ImamJhe/Skripsi/Gambaran Alat/IMG_20220808_1250011.jpg

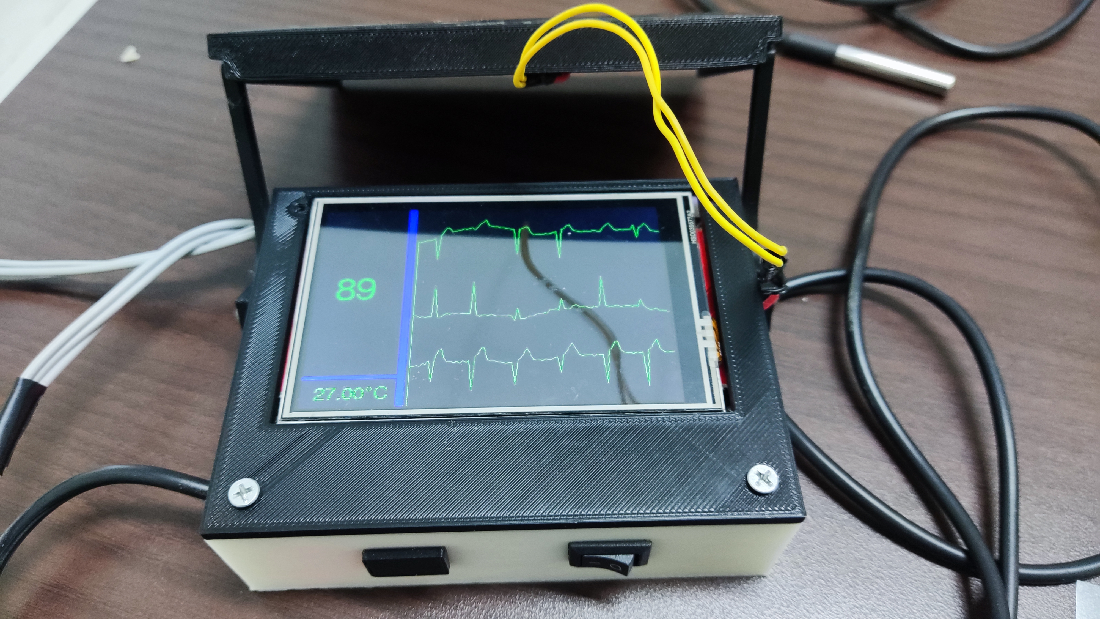
Gambaran Alat/IMG_20220808_1250011.jpg
