ImamJhe/Skripsi/Gambaran Alat/IMG_20220808_123620.jpg

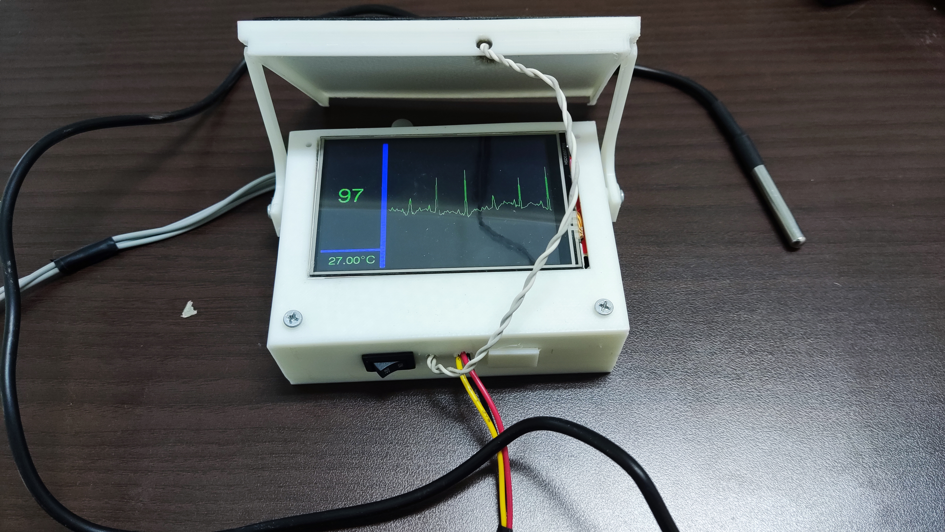
Gambaran Alat/IMG_20220808_123620.jpg
