ImamJhe/Skripsi/Readme.md

# Video Pengenalan Alat
https://github.com/ImamJhe/Skripsi/assets/95597578/f38b6d7f-bc4e-496a-82b5-ecb6b56aeb42

# Gambaran Grafik Alat pada web local
AD8232_ILI9488_1_zoom
AD8232_SH1106_zoom
ADS1293_ILI9488_1
ADS1293_ILI9488_1_zoom

# Banner Jurnal Skripsi
Banner_Jurnal
