ImamJhe/Skripsi/Gambaran Alat/bagian samping.png

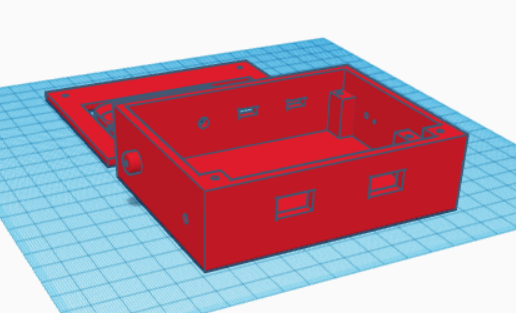
Gambaran Alat/bagian samping.png
