ImamJhe/Skripsi/Gambaran Alat/Dimensi pxl.png

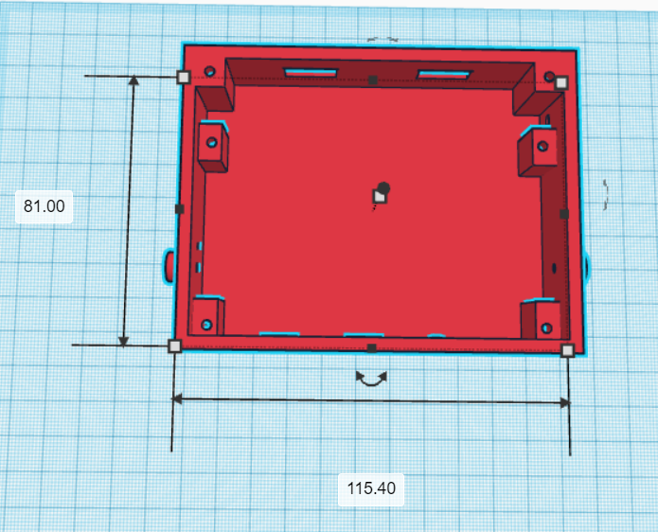
Gambaran Alat/Dimensi pxl.png
