ImamJhe/Skripsi/Gambaran Alat/dimensi tinggi.png

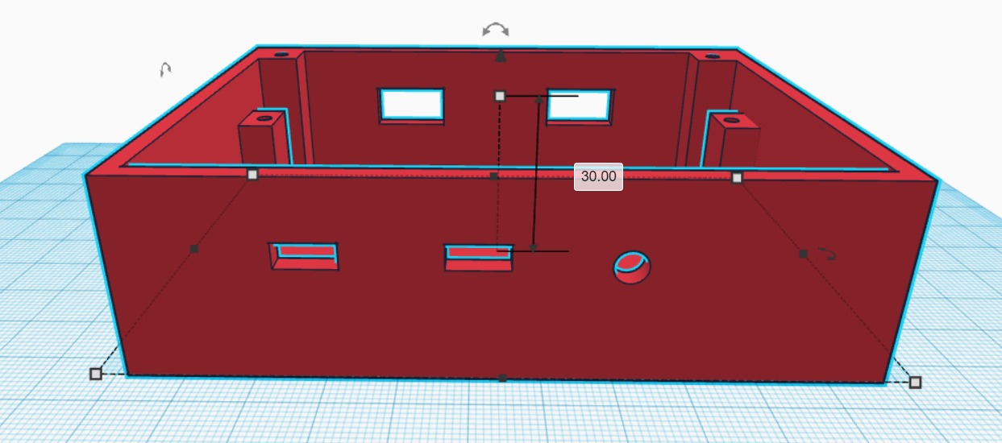
Gambaran Alat/dimensi tinggi.png
