ImamJhe/Skripsi/Gambaran Alat/IMG_20220808_123228.jpg

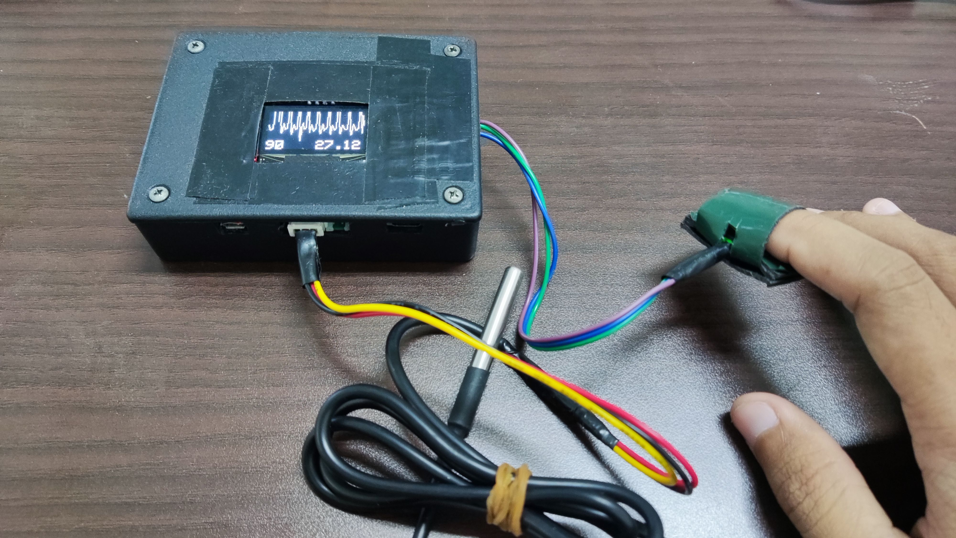
Gambaran Alat/IMG_20220808_123228.jpg
