ImamJhe/Skripsi/Gambaran Alat/IMG_20220808_123642.jpg

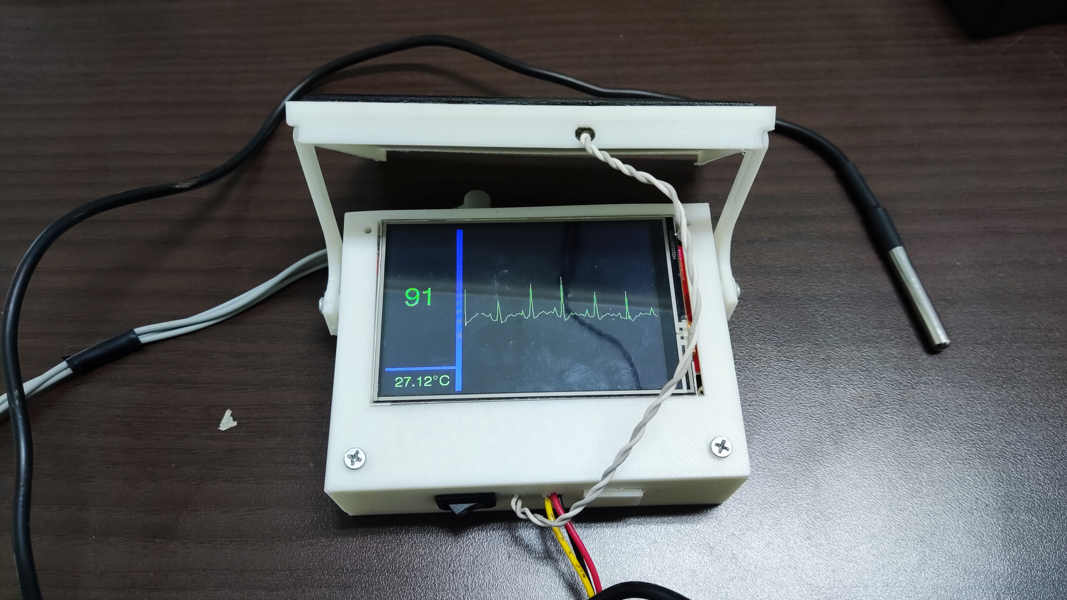
Gambaran Alat/IMG_20220808_123642.jpg
