ImamJhe/Skripsi/Gambaran Alat/IMG_20220808_124958.jpg

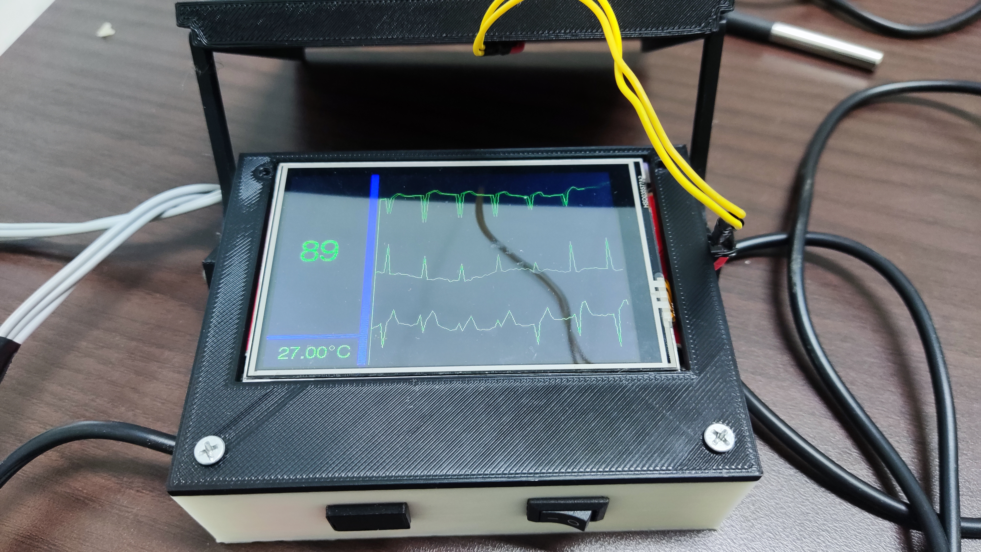
Gambaran Alat/IMG_20220808_124958.jpg
