ImamJhe/Skripsi/Laporan Alat/Gambar Grafik di Webserver/AD8232_SH1106.png

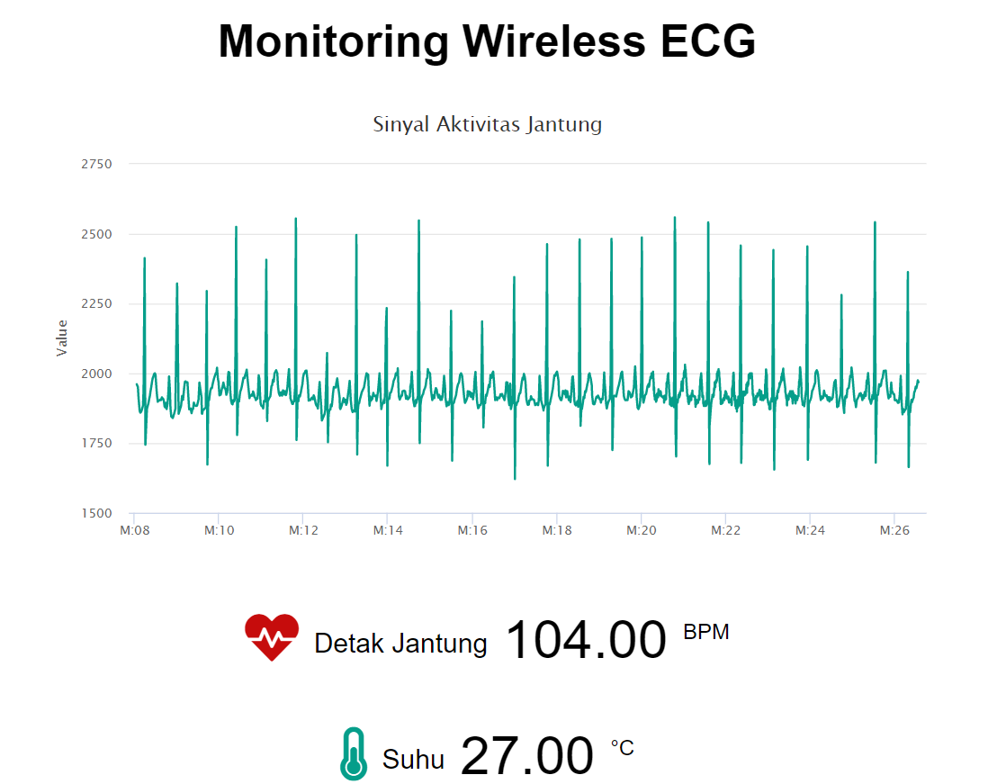
Laporan Alat/Gambar Grafik di Webserver/AD8232_SH1106.png
