ImamJhe/Skripsi/Laporan Alat/Gambar Grafik di Webserver/ADS1293_ILI9488_3.png

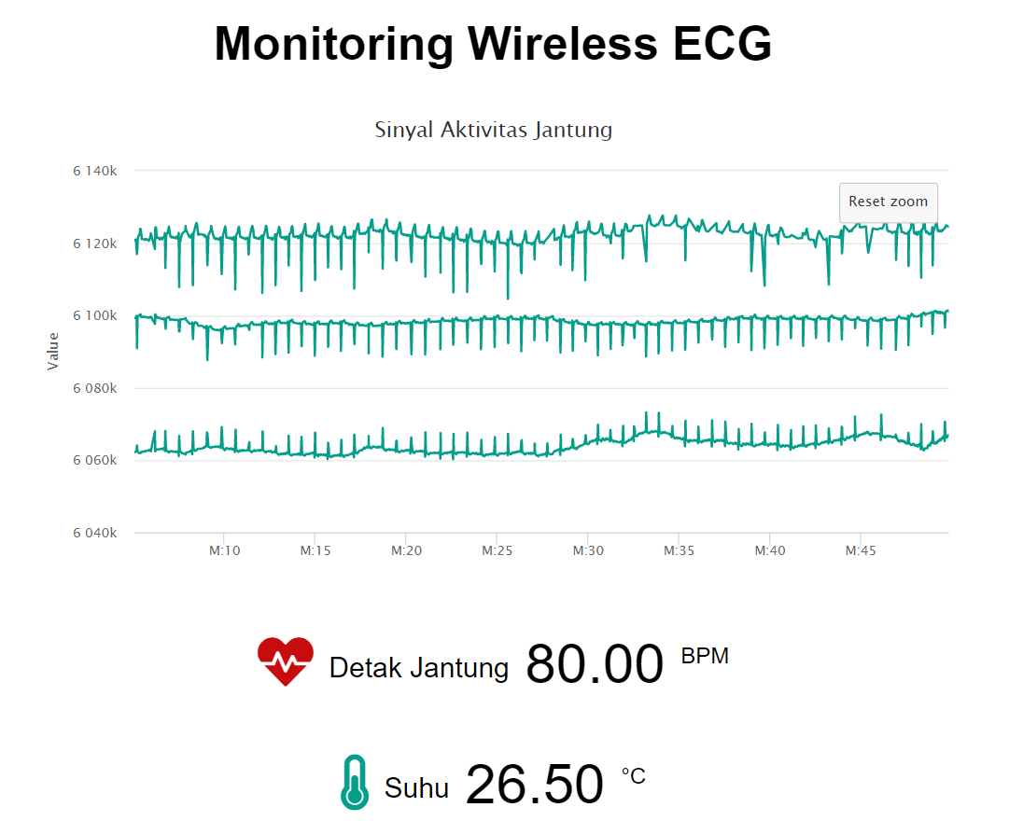
Laporan Alat/Gambar Grafik di Webserver/ADS1293_ILI9488_3.png
