ImamJhe/Skripsi/Laporan Alat/Gambar Grafik di Webserver/ADS1293_ILI9488_3_zoom.png

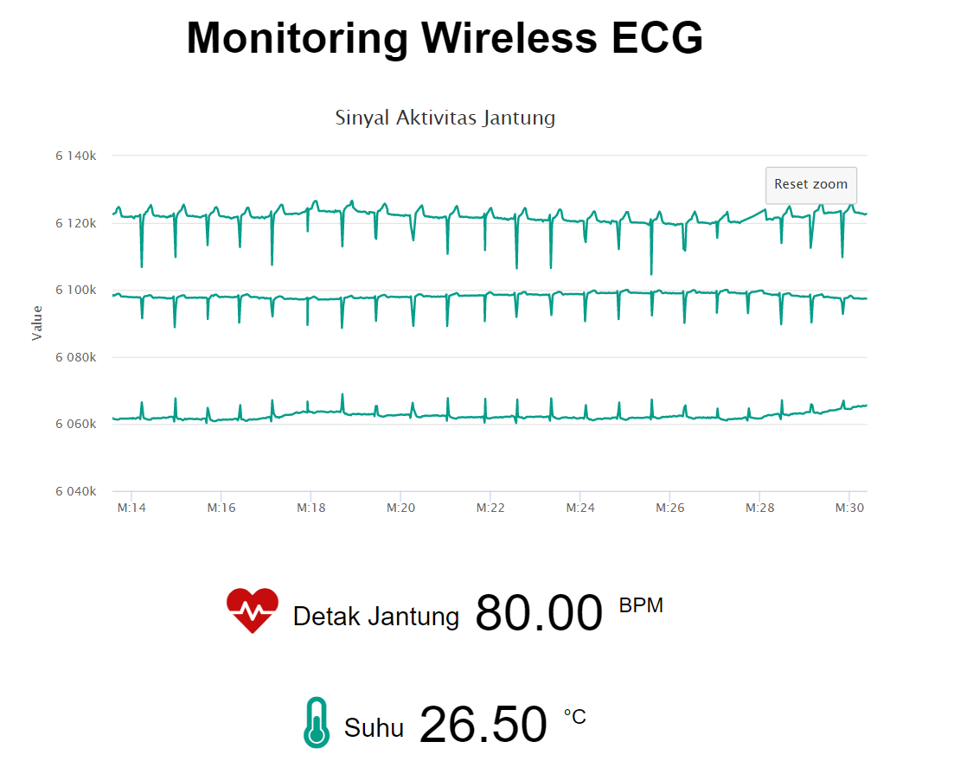
Laporan Alat/Gambar Grafik di Webserver/ADS1293_ILI9488_3_zoom.png
