ImamJhe/Skripsi/PCB/AD8232/Skematik_AD8232_.png

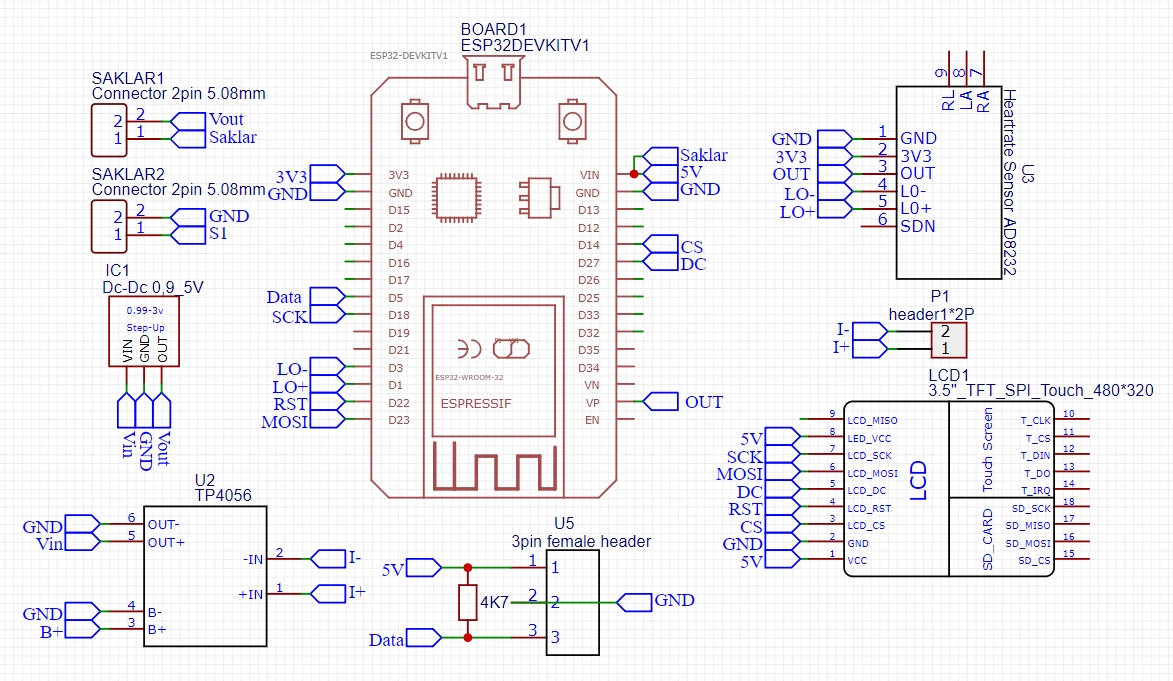
PCB/AD8232/Skematik_AD8232_.png
