ImamJhe/Skripsi/PCB/ADS_1293/Ref_3_ECG.png

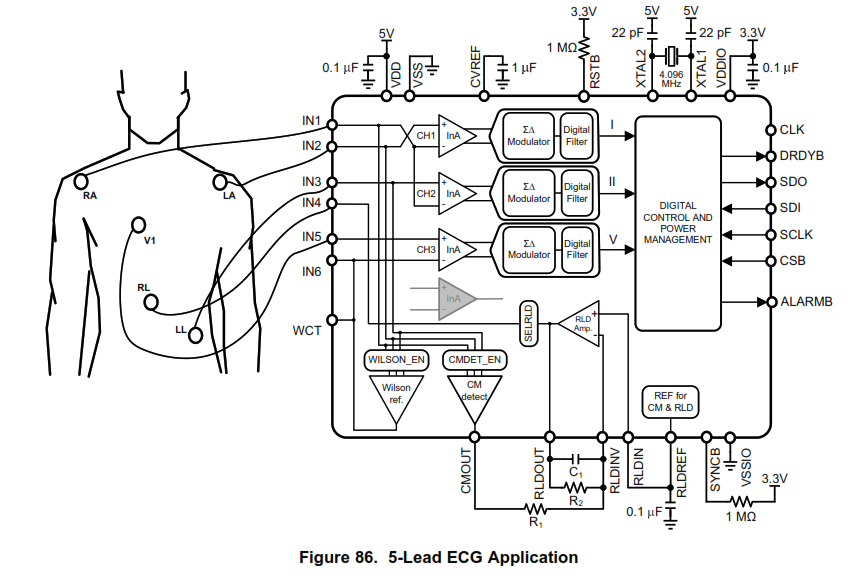
PCB/ADS_1293/Ref_3_ECG.png
