ImamJhe/Skripsi/PCB/ADS_1293/Skematik.png

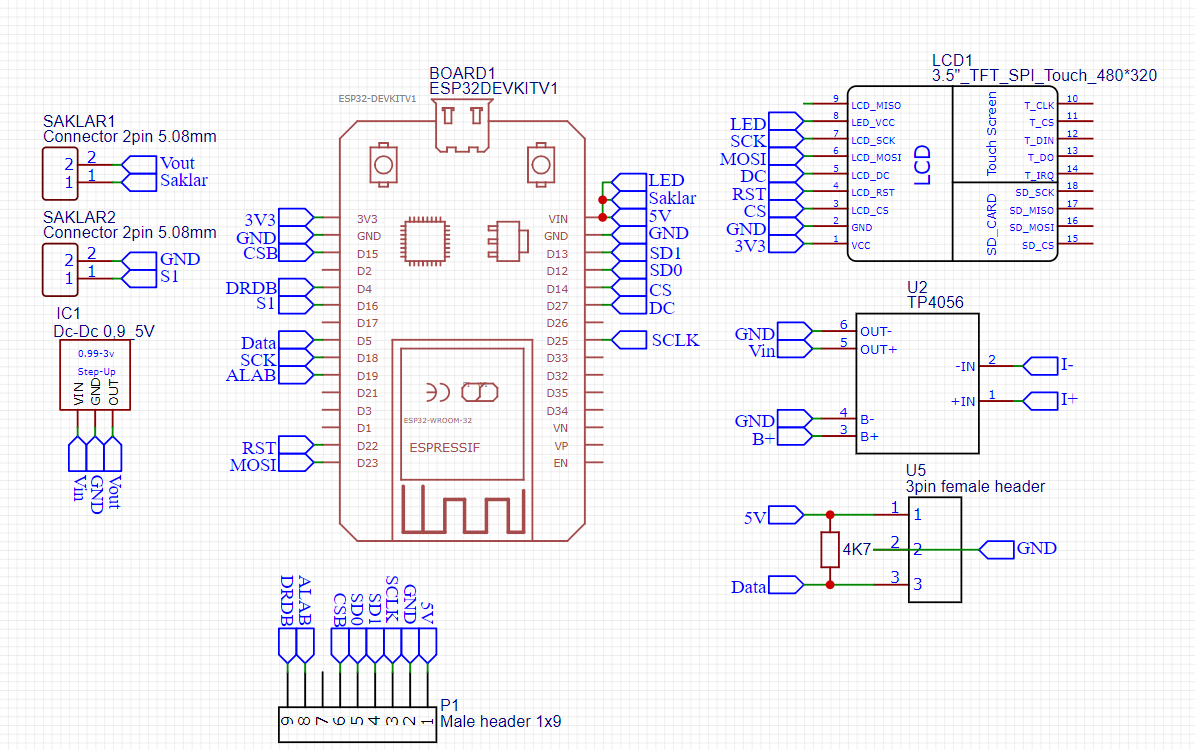
PCB/ADS_1293/Skematik.png
