ImamJhe/Skripsi/PCB/Pulse Heart Sensor/Skematik pulse heart sensor.png

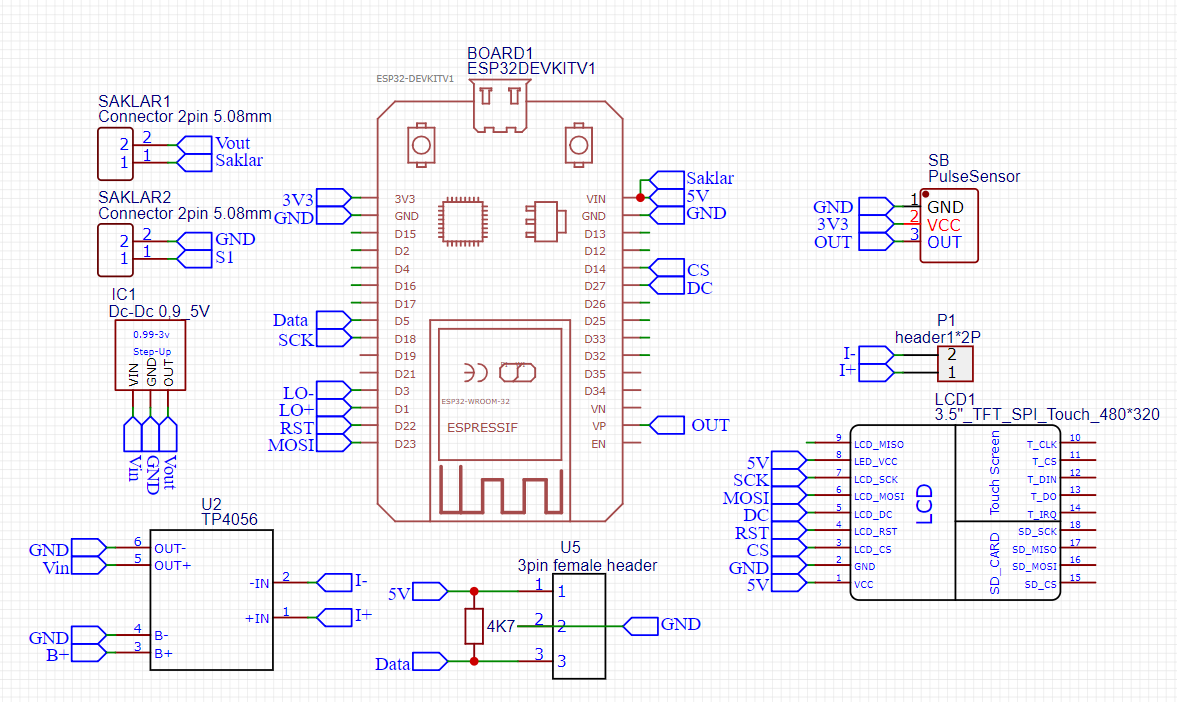
PCB/Pulse Heart Sensor/Skematik pulse heart sensor.png
