ImamJhe/Skripsi/(list of files, drawings)

Other design files:
PCB/AD8232/PCB_AD8232_.json
PCB/ADS_1293/PCB_ADS1293.json
